SourceryOne/Arduino-ADSR/ADSR BOM.pdf

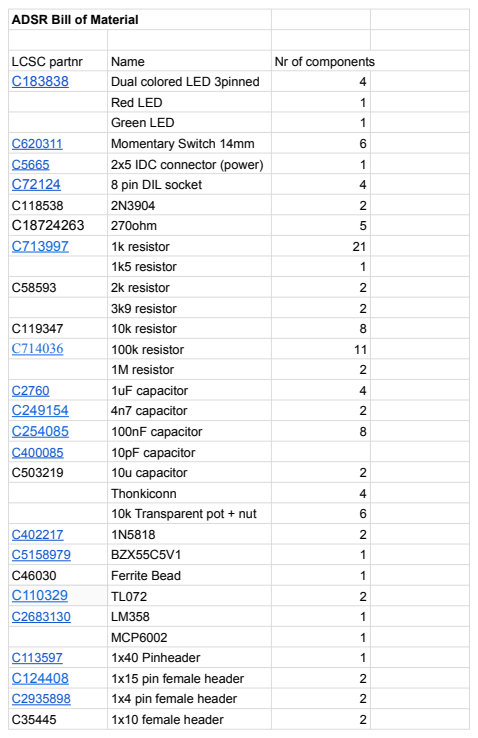
[picture p5: page 1]
LCSC partnr; Name; Nr of components; Dual colored LED 3pinned; Red LED; Green LED; Momentary Switch 14mm; 2x5 IDC connector (power); 8 pin DIL socket; 270ohm; 1k resistor; 1k5 resistor; 2k resistor; 3k9 resistor; 10k resistor; 100k resistor; 1M resistor; 1uF capacitor; 4n7 capacitor; 100nF capacitor; 10pF capacitor; 10u capacitor; Thonkiconn; 10k Transparent pot + nut; BZX55C5V1; Ferrite Bead; MCP6002; 1x40 Pinheader; 1x15 pin female header; 1x4 pin female header; 1x10 female header

ADSR Bill of Material
