SourceryOne/Arduino-ADSR/Schematic_MiaW-ADSR-Arduino-ADSR_2025-07-05.pdf

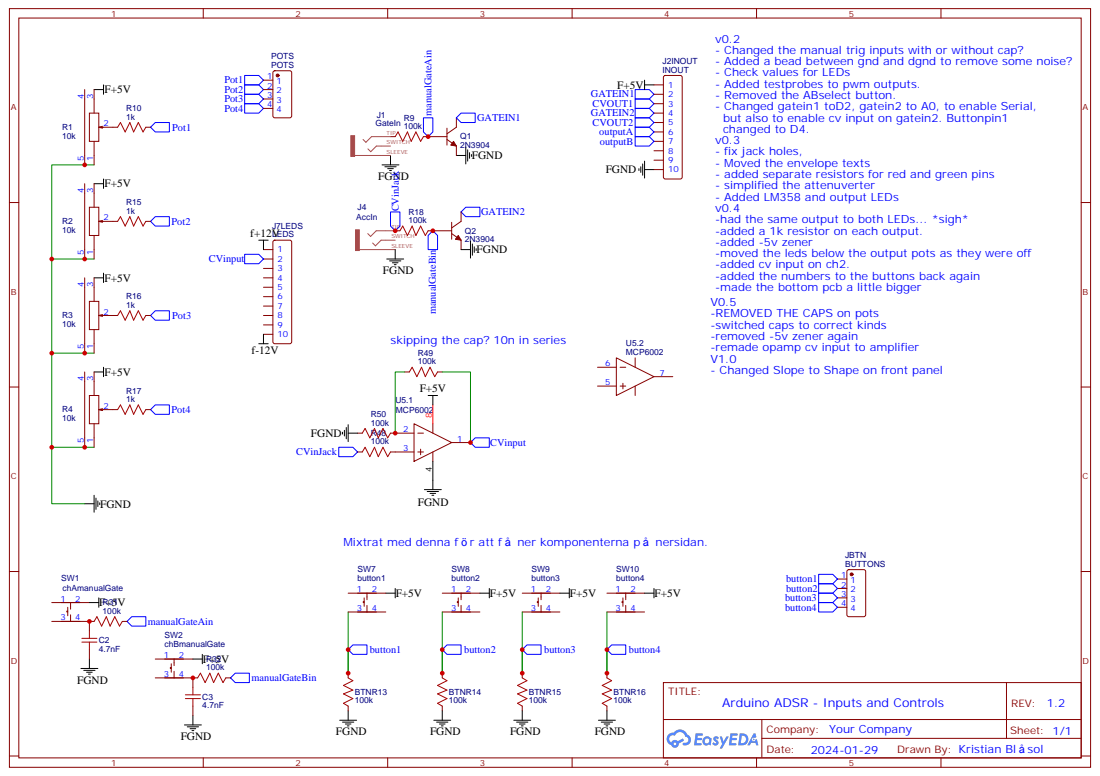
[picture p6: page 1]

- Changed the manual trig inputs with or without cap?
- Added a bead between gnd and dgnd to remove some noise?
- Check values for LEDs
- Added testprobes to pwm outputs.
- Removed the ABselect button.
- Changed gatein1 toD2, gatein2 to A0, to enable Serial,
but also to enable cv input on gatein2. Buttonpin1
changed to D4.
- fix jack holes,
- Moved the envelope texts
- added separate resistors for red and green pins
- simplified the attenuverter
- Added LM358 and output LEDs
-had the same output to both LEDs... *sigh*
-added a 1k resistor on each output.
-added -5v zener
-moved the leds below the output pots as they were off
-added cv input on ch2.
-added the numbers to the buttons back again
-made the bottom pcb a little bigger

-REMOVED THE CAPS on pots
-switched caps to correct kinds
-removed -5v zener again
-remade opamp cv input to amplifier
- Changed Slope to Shape on front panel

Mixtrat med denna f r att f ner komponenterna p nersidan.

Drawn By: Kristian Bl sol

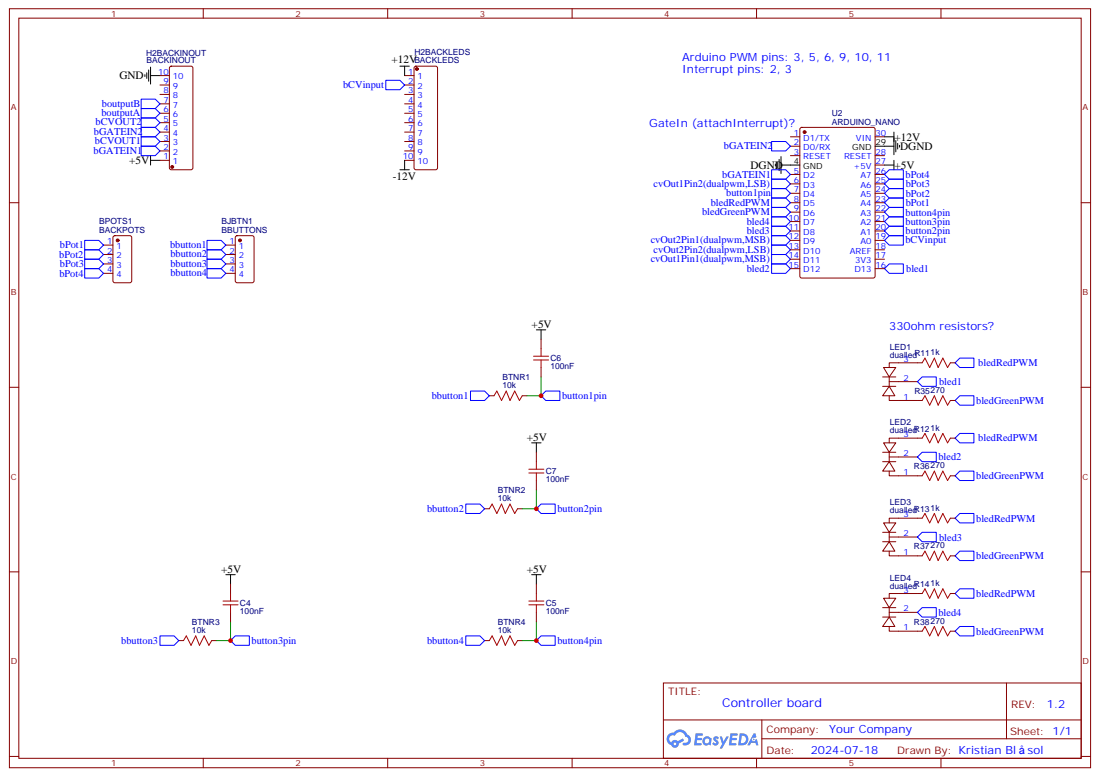
[picture p7: page 2]

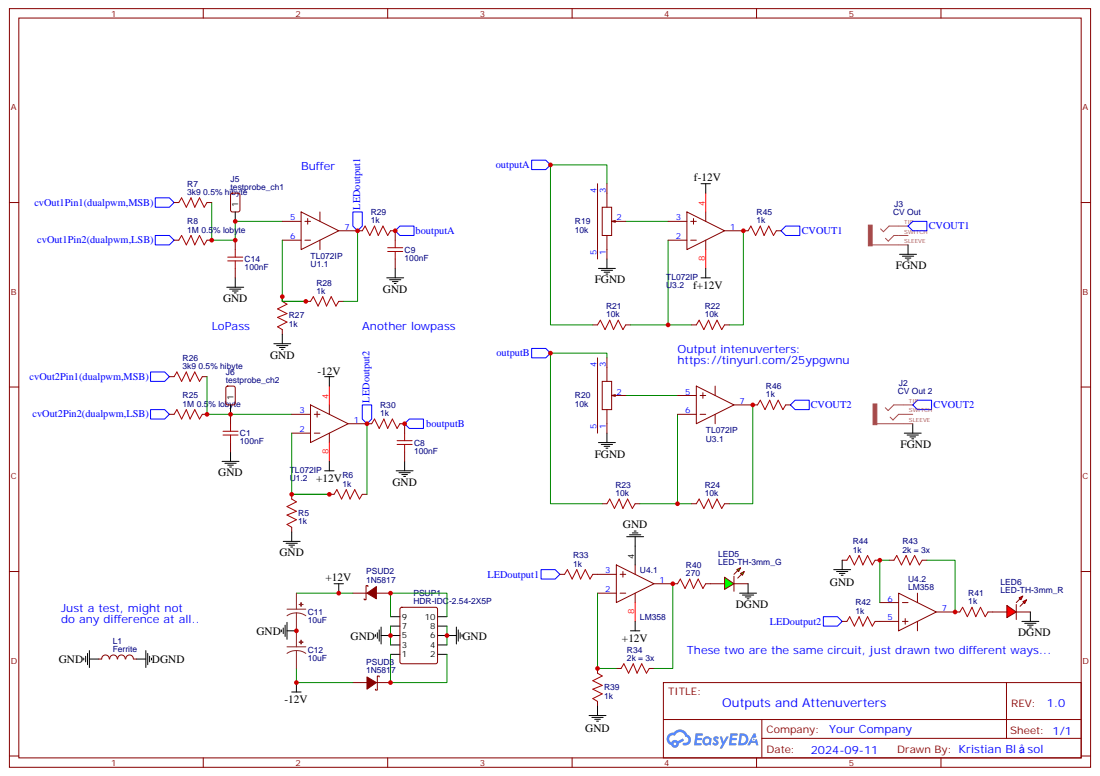
[picture p8: page 3]

Just a test, might not
do any difference at all..

These two are the same circuit, just drawn two different ways...
