SourceryOne/Arduino-ADSR/config.h

// Config.h
#ifndef CONFIG_H
#define CONFIG_H

//PINASSIGNMENT
const int redPWM = 6;           // the PWM pin the LED is attached to
const int greenPWM = 5;           // the PWM pin the LED is attached to
const int led1=13;
const int led2=12;
const int led3=8;
const int led4=7;
const int gatein1=1;
const int gatein2=0;

const int attackPot=A4;
const int decayPot=A5;
const int sustainPot=A6;
const int releasePot=A7;


#endif
