SourceryOne/Arduino-ADSR/(commit log)

2024-11-08 Update test_check_for_trig_send_A.ino
    fixed the maxValue, all variables using maxValue should be unsigned.
    [test_check_for_trig_send_A.ino]
2025-07-05 Final schematics 1.0
    Schematics for the v1.0 boards.
2025-08-05 Added BOM
2025-09-01 Code version 0.82 Minor changes, Better response
    *v0.81 fixed a bunch of compiler errors.
    *v0.82 removed all serial debug, for better response to short trigs.
    [ArduinoADSR.ino, B10_Config.ino, B20_Setup.ino, B30_Loop.ino, B49_Menu4.ino, B60_CatchPots.ino]
2026-01-16 v0.83 Change of slope log/lin/antilog fixed.
    Thank you Jos Bouten for finding the error.
    [ArduinoADSR.ino, B46_Menu1.ino]
